tknpow22/temperature_switch/temperature_control_panel_with_ts.png

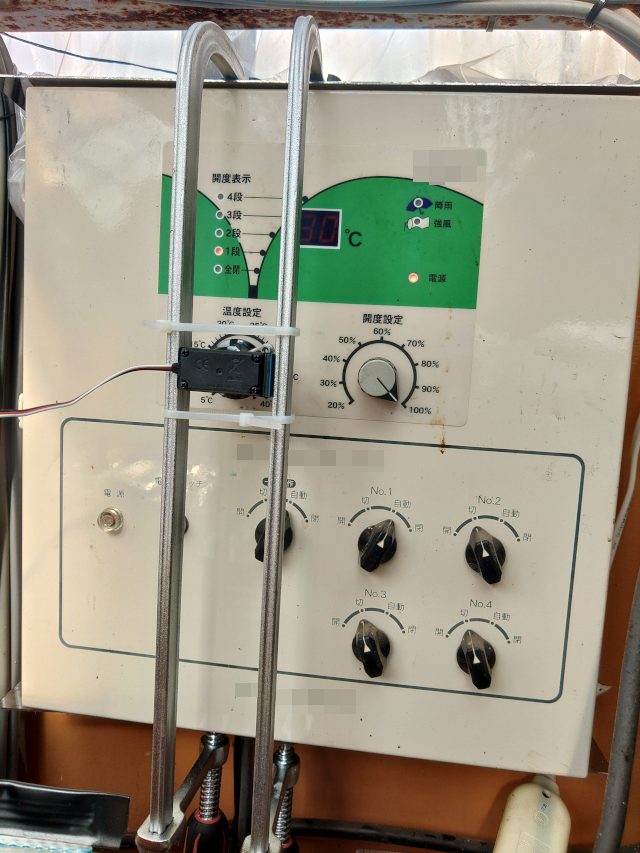
temperature_control_panel_with_ts.png
