tknpow22/temperature_switch/temperature_control_panel.png

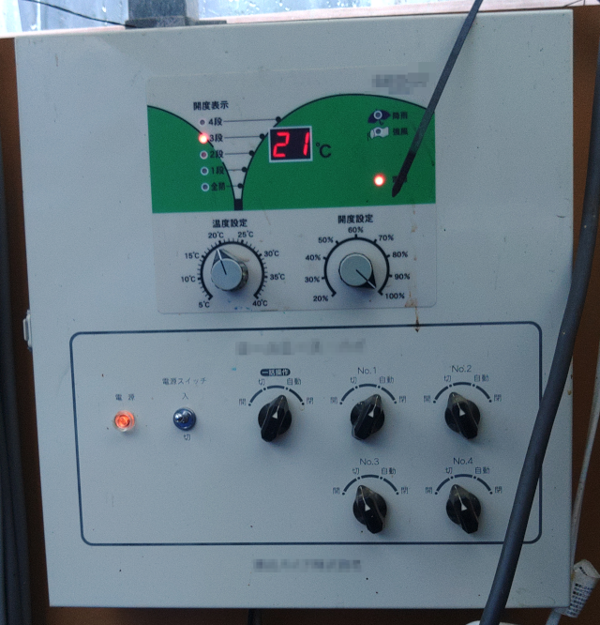
temperature_control_panel.png
