tknpow22/temperature_switch/README.md

# temperature_switch

農業用ハウスの天窓制御盤の温度つまみを操作します。
朝は 20 度程度に設定し、天窓が開くとともに徐々に設定温度を上げ、午後は少し高めの温度に設定したくて、作りました。
実際に自身の農業用ハウスで使っていますが、自己満足のためにここにアップしただけなので、あまりオススメできる代物ではありません。
自身の書いたコードを含め、色々と信頼できないので、昼間だけ電源を入れて使っています。

## 環境等

- Arduino Uno Rev3

- KKHMF 2個 MB102 ブレッドボード 電源 ブレッドボード 電源モジュール 3.3V 5V

- FEETECH FS5103B スタンダードPWMサーボ

- WINGONEER 小型DS3231 AT24C32 I2Cモジュール用の高精度リアルタイムクロックモジュール,ボタン電池付き（A145）

- EasyWordMall 5個セット AT24C256 I2C インターフェース EEPROM メモリ モジュール ボード LEDインジケータ付き

- zmart LCD2004 + I2C 2004 20x4 2004A ブルー スクリーン HD44780 文字 LCD/w IIC / I2C シリアルインタフェース アダプタ モジュール

- タクトスイッチ×5

- 電解コンデンサ(100μF)×2

- 抵抗(10kΩ)×5

- ブレッドボード×2(フル、ハーフ)

- ジャンパワイヤ等少々

- Punasi 9V 2A AC/DCアダプター電源アダプター×2

- 25Tサーボホーン

- サトーパーツ つまみ Φ34 黒 指示線あり シャフト径Φ6用 K-2901-M(温度つまみ用)

- 高儀 GISUKE L型クランプ GL-500G×2

- タイラップ少々

- (オプション)プリント基板等

## 補足等

- 開発には Arduino IDE を使いました。

- サーボモーターの回転範囲は 180 度とし、温度つまみを 11 度から 34 度の範囲で設定できる仕様です。

- 電解コンデンサはよくわからないまま、おまじないとして入れています。

- 温度つまみを回すためのサーボモーターを数種類試したのですが、ものによっては電源投入直後に 360 度ぐるぐる回り始めてしまうものがあり、温度つまみを壊してしまう可能性があるため、できるだけトルクが少なく、びびりもほぼなく、180 度以上は動かない FS5103B を選びました。

## その他

- ハードのことはよくわからず、ネットで探したサンプルを組み合わせて作成しました。

- ブレッドボードのまま使う予定でしたが、移動するたびに接続が外れるので、実機はブレッドボード型のプリント基板を使い、半田付けしました。

- 温度つまみをサーボホーンにネジで固定し、元の温度つまみと交換後、サーボモーターを取り付けました。

- 温度制御盤にクランプを取り付け、そこにサーボモーターをタイラップで固定しました。

- http://tkb11.com/misc/temperature-switch.php
