tknpow22/temperature_switch/temperature_switch_bread_board.png

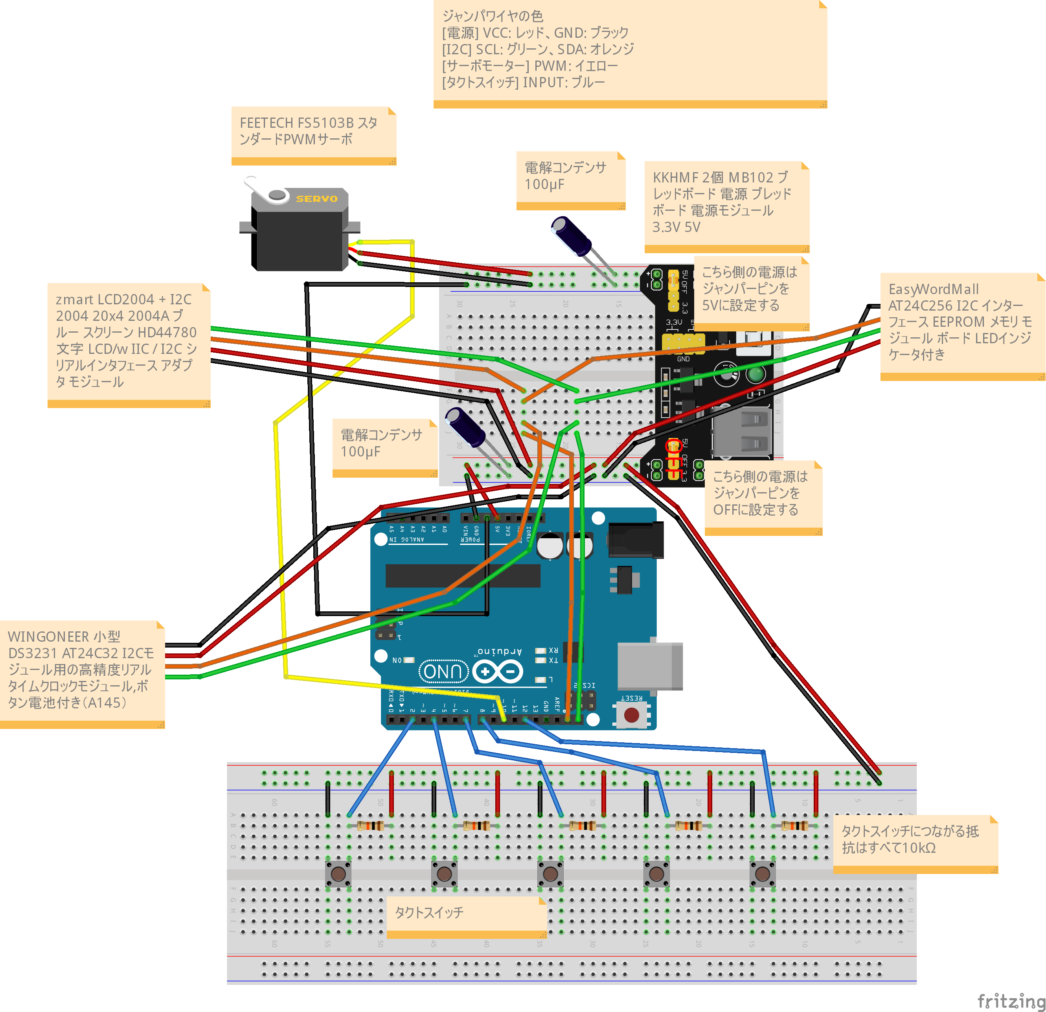
temperature_switch_bread_board.png
