tknpow22/temperature_switch/(commit log)

2023-12-18 最初のバージョン
2023-12-18 接続後の写真を追加
2023-12-18 README.mdを修正
2023-12-21 午後の時間帯の温度をあげる日の入り前の時間の幅を変更した
2024-01-01 フリーズ対策のためWDTを導入した
2024-02-01 朝の温度と午後の温度の最低値を変更した
2024-02-04 午後の温度設定を日の入りからの相対時間ではなく、絶対時刻で指定するよう変更した
2024-02-05 コメント等文言を修正した
2024-02-15 午前の温度設定の開始と終了に同じ温度を設定できるようにした
2024-03-05 画面の表示順を変更した
2024-04-16 午前の温度設定時に温度上下ボタンでの操作の改善
2024-04-16 手動モードを覚えておくことにした
2024-04-19 設定画面でスクロールらしきものを実装した
2024-04-20 表示の行位置の判定を正しく直した
2024-04-20 サーボモーターの動作をクラスにまとめた
2024-04-20 サーボモーターの動作をクラスにまとめた(修正)
2024-04-20 文言等修正
2024-04-23 ディスプレイ表示をまとめた
2024-04-23 日の出・日の入り時刻取得をまとめた
2024-04-23 設定の読込、保存をまとめた
2024-04-23 モード毎の動作をまとめた
2024-04-23 タクトスイッチの処理をまとめた
2024-04-23 コメントの修正
2024-04-23 緯度・経度を設定できるようにした
2024-04-24 文言修正
2024-04-24 表示をキャッシュするように変更した
2024-04-24 loop()でのdelay間隔を短くしてみた
2024-04-24 delayが短すぎて設定で値ごとの遷移でさらに次の項目に飛んでしまうので値を増やした
2024-04-25 リセットパラメータを追加
2024-04-26 リセット機能を追加した
2024-04-26 変数名を変更した
2024-04-27 いろいろ修正
2024-04-27 引数の修正
2024-04-27 午後の処理温度のif条件が不要なので外した
2024-04-30 リセット処理の実装し直しとボタン操作の変更
2024-04-30 USAGE.txtを修正
2024-05-03 モード毎の処理をクラス側へ移動した
2024-05-03 MyServo::attachの返り値を返してなかったのを修正
2024-05-05 コメントがおかしいのを修正した
2024-05-06 コメントを修正した
2024-05-27 タクトスイッチの状態の取得をTask側に移動した
2024-05-27 コメントの追加
2024-06-01 変数名の整理
2024-06-01 ソース整理
2024-06-03 画面モードと動作モードの分離
2024-06-03 モードの分離
2024-06-04 リセット処理の実装
2024-06-05 コメントほか修正
2024-06-24 温度処理を変更
2024-06-24 設定画面の表示順等を修正
2024-06-24 コードの整理
2025-02-17 サーボの移動範囲を調整できるように変更した
